LoZioo/AudioMonitor/README.md

# AudioMonitor
AudioMonitor project repository.
