LoZioo/AudioMonitor/src/ESP32/AudioMonitor-Schematics/Kicad/AudioMonitor.kicad_sch

## KiCad design src/ESP32/AudioMonitor-Schematics/Kicad/AudioMonitor.kicad_sch (2022-05-08)

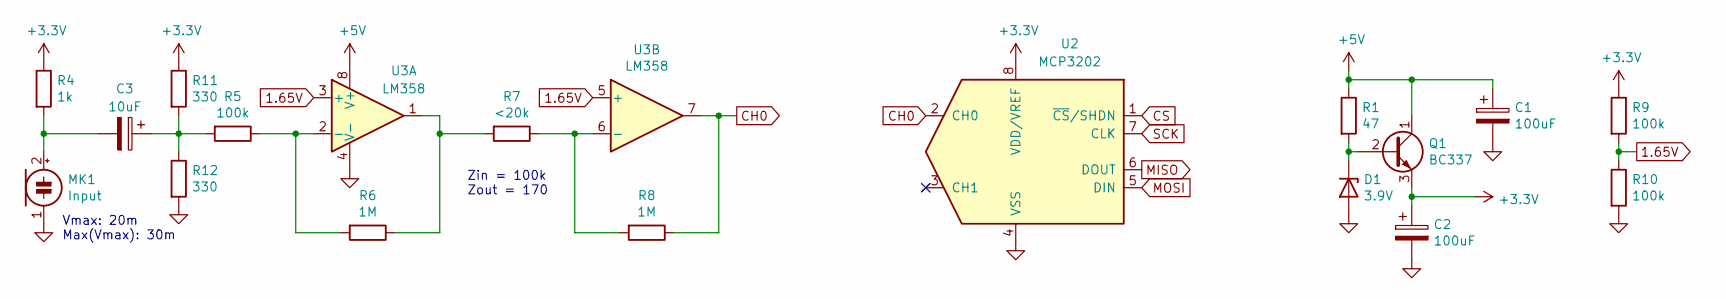
[picture p10: schematic AudioMonitor.kicad_sch]

Parts:
C1, C2: 100uF
C3: 10uF
D1: 3.9V
MK1: Input
Q1: BC337; TO-92_Inline
R1: 47
R4: 1k
R5, R9, R10: 100k
R6, R8: 1M
R7: <20k
R11, R12: 330
U2: MCP3202
U3: LM358

Connections:
1.65V: R9.2, R10.1, U3.3 (+), U3.5 (+)
+3.3V: C2.1, Q1.3 (E), R4.1, R9.1, R11.1, U2.8 (VDD/VREF)
+5V: C1.1, Q1.1 (C), R1.1, U3.8 (V+)
CH0: R8.1, U2.2 (CH0), U3.7
CS: U2.1 (~CS/SHDN)
GND: C1.2, C2.2, D1.2 (A), MK1.1 (-), R10.2, R12.2, U2.4 (VSS), U3.4 (V-)
MISO: U2.6 (DOUT)
MOSI: U2.5 (DIN)
unnamed: C3.1, R5.2, R11.2, R12.1
unnamed: C3.2, MK1.2 (+), R4.2
unnamed: D1.1 (K), Q1.2 (B), R1.2
unnamed: R5.1, R6.2, U3.2 (-)
unnamed: R6.1, R7.2, U3.1
unnamed: R7.1, R8.2, U3.6 (-)
SCK: U2.7 (CLK)

Notes on the sheet:
Zin = 100k Zout = 170
Vmax: 20m Max(Vmax): 30m
