LoZioo/AudioMonitor/src/ESP32/Test/1.1.0/README.md

# Specifiche dei test effettuati

## Testo di esempio utilizzato
Un'insieme di vettori di uno spazio vettoriale è formato da vettori linearmente indipendenti se nessuno di essi può essere espresso come combinazione lineare degli altri vettori dell'insieme.

<br>

## Descrizione dei test effettuati
-	Il file audio `Final-test.mp3` è stato registrato con:
	-	Frequenza di campionamento pari a `16kHz`.
	-	Una risoluzione di `12bit`.

<br>

-	Il file `Final-test.aup3` è un file progetto Audacity che contiene le registrazioni effettuate alle seguenti distanze:
	-	0cm
	-	50cm
	-	150cm
	-	250cm

<br>

-	Ogni registrazione avrà la sua corrispettiva traccia a cui sono stati applicati i seguenti enhanchments:
	-	0/50/150/250cm normalized\
		La forma d'onda della traccia è stata normalizzata tra `[-1db, 1db]`.
