LoZioo/AudioMonitor/src/ESP8266/AudioMonitor/include/const.h

//Porta UDP locale.
#define UDP_LOCAL_PORT 5000

//SoftSPI.
#define SOFTSPI_MOSI	1
#define SOFTSPI_MISO	3
#define SOFTSPI_SCK		0

//Chip select ADC.
// #define ADC_CS 2
#define ADC_CS 15
