LoZioo/AudioMonitor/(commit log)

2022-03-23 chore: Deleted old ESP32/AudioMonitor/.gitignore
2022-03-27 feat: Added audio tests for the ESP32 version.
2022-05-07 fix: now the code is running properly
    [const.h, main.cpp]
2022-05-08 feat: updated schematics
    [AudioMonitor.kicad_sch, Cimice.kicad_pcb, Cimice.sch]
